omarmustafa130/robo-tech-boat/Boat/Additional symbols, footprints, & 3D parts/CAN/LIB_MS-22D28-G020/MS-22D28-G020/3D/MS-22D28-G020.stp

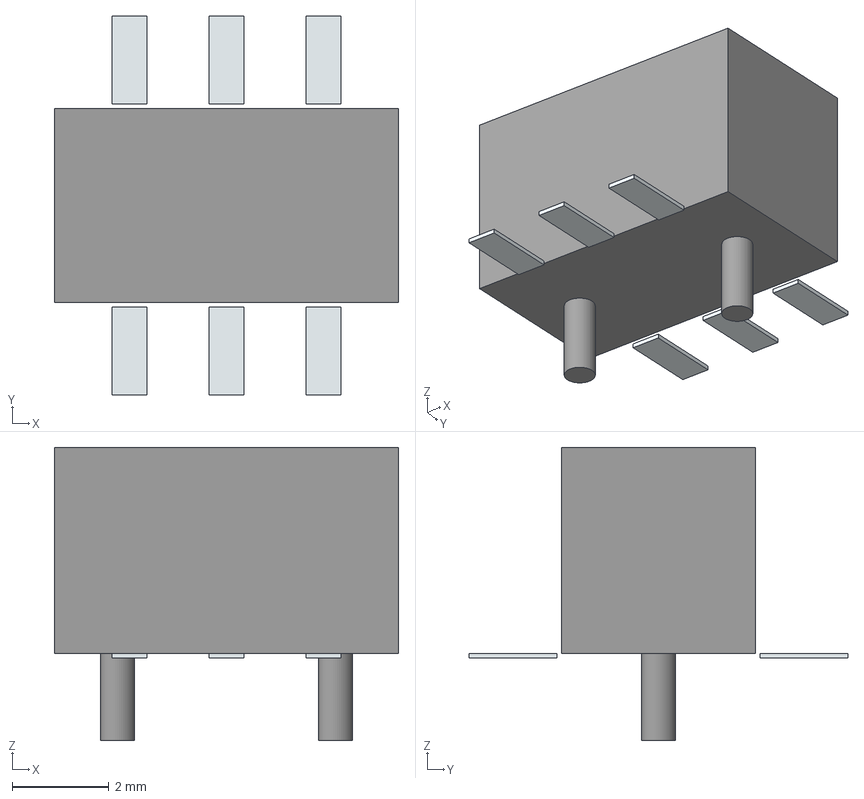
[picture p1: CAD file, 2025-05-22]
Boat/Additional symbols, footprints, & 3D parts/CAN/LIB_MS-22D28-G020/MS-22D28-G020/3D/MS-22D28-G020.stp
7.10 x 7.82 x 6.05 mm
Pins
Lugs
