omarmustafa130/robo-tech-boat/Boat/Additional symbols, footprints, & 3D parts/ENC28J60-I_SO/ENC28J60-I_SO.step

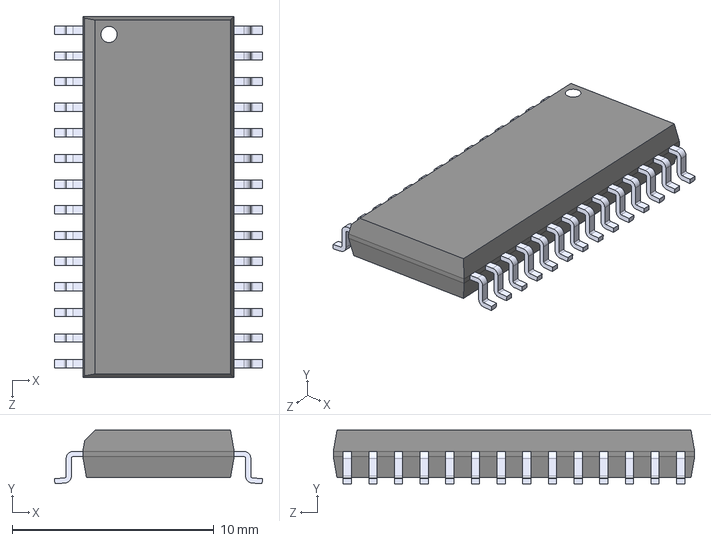
[picture p2: CAD file, 2025-05-22]
Boat/Additional symbols, footprints, & 3D parts/ENC28J60-I_SO/ENC28J60-I_SO.step
10.3 x 2.65 x 17.9 mm
