omarmustafa130/robo-tech-boat/Boat/Additional symbols, footprints, & 3D parts/ETHERNET/LIB_HSO321S/HSO321S/3D/HSO321S.stp

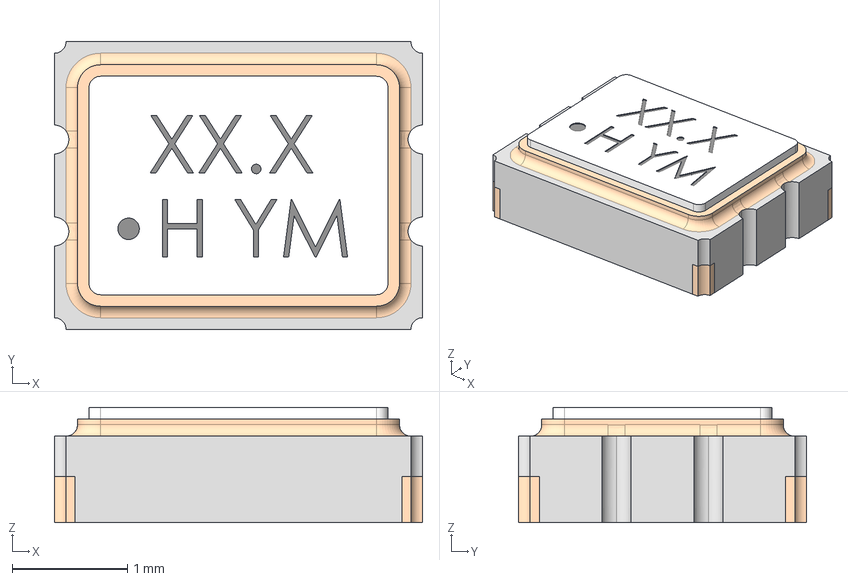
[picture p3: CAD file, 2025-05-22]
Boat/Additional symbols, footprints, & 3D parts/ETHERNET/LIB_HSO321S/HSO321S/3D/HSO321S.stp
3.20 x 2.50 x 1.00 mm
SSW024576F3CHC-T
SSW024576F3CHC-T003
SSW024576F3CHC-T004
SSW024576F3CHC-T002
SSW024576F3CHC-T001
