omarmustafa130/robo-tech-boat/Boat/Additional symbols, footprints, & 3D parts/ETHERNET/LIB_W5500/W5500/3D/W5500.stp

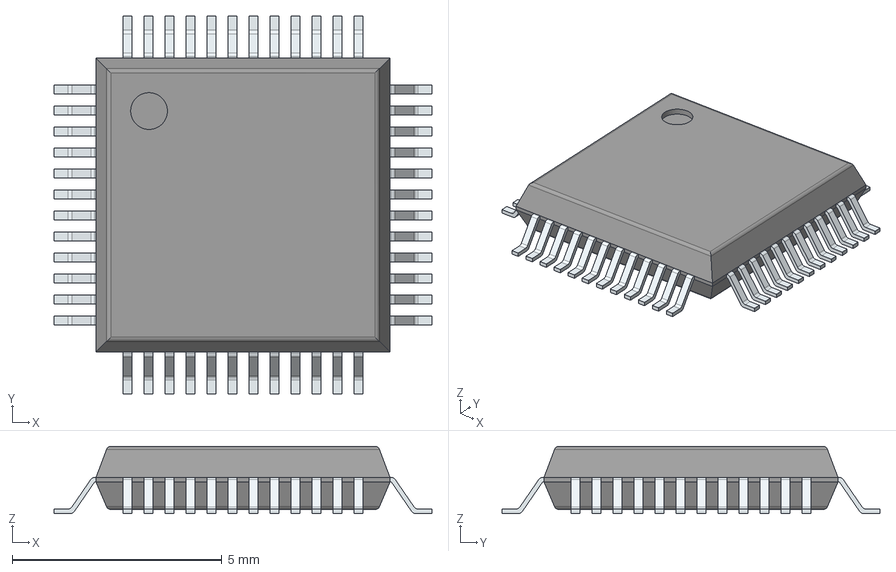
[picture p4: CAD file, 2025-05-22]
Boat/Additional symbols, footprints, & 3D parts/ETHERNET/LIB_W5500/W5500/3D/W5500.stp
9.00 x 9.00 x 1.60 mm
PinsArrayLR
PinsArrayTB
