omarmustafa130/robo-tech-boat/Boat/Additional symbols, footprints, & 3D parts/ETHERNET/RJ45_163141781-659-5-2301994-9/5-2301994-9.stp

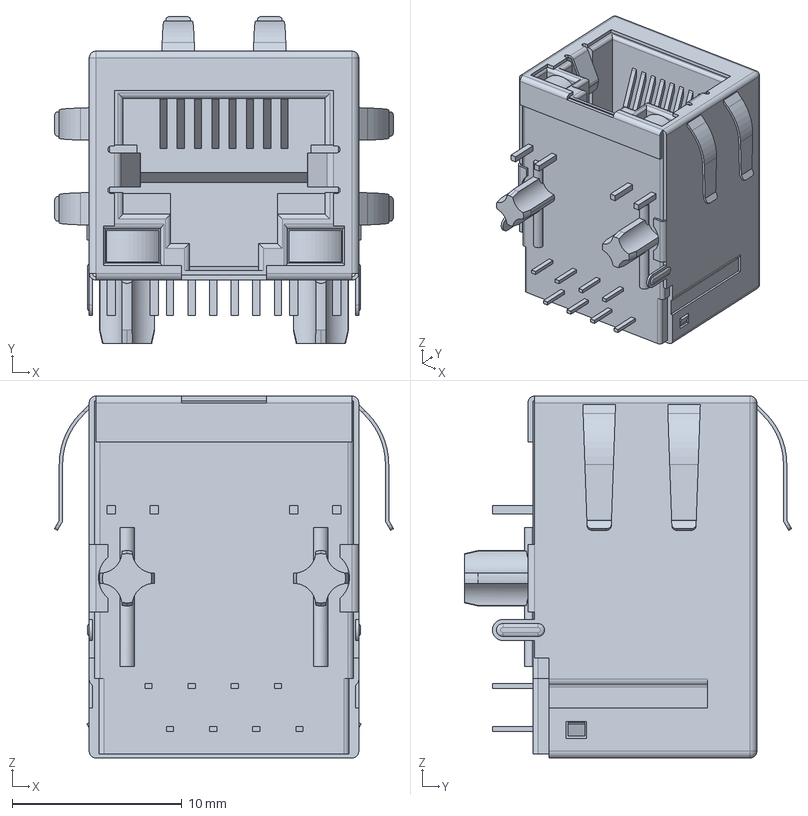
[picture p5: CAD file, 2025-05-22]
Boat/Additional symbols, footprints, & 3D parts/ETHERNET/RJ45_163141781-659-5-2301994-9/5-2301994-9.stp
20.0 x 19.3 x 21.4 mm
