omarmustafa130/robo-tech-boat/Boat/Additional symbols, footprints, & 3D parts/Power Circuit/LIB_1N5822/1N5822/3D/1N5822.stp

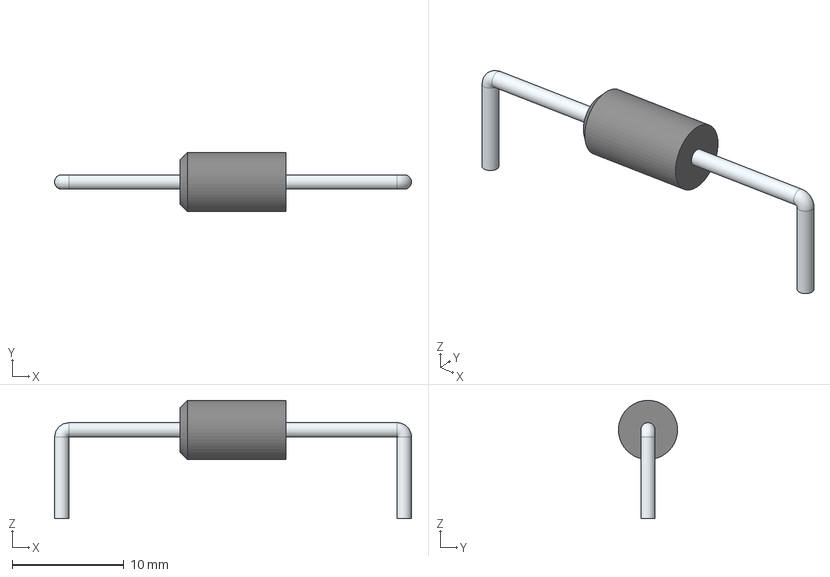
[picture p6: CAD file, 2025-05-22]
Boat/Additional symbols, footprints, & 3D parts/Power Circuit/LIB_1N5822/1N5822/3D/1N5822.stp
32.0 x 5.30 x 10.6 mm
