omarmustafa130/robo-tech-boat/Boat/Additional symbols, footprints, & 3D parts/Power Circuit/LIB_SMAJ58A/SMAJ58A/3D/SMAJ58A.stp

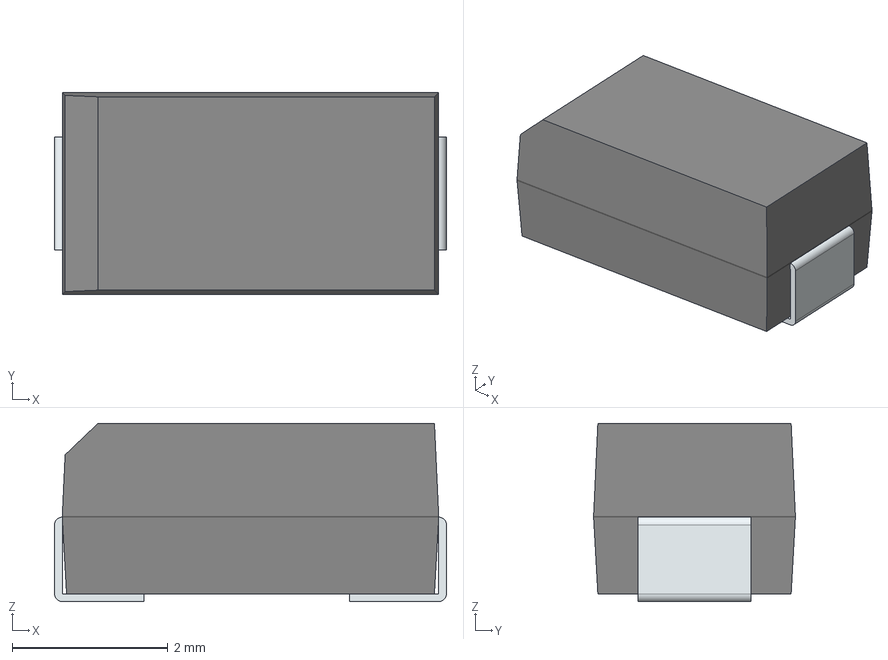
[picture p7: CAD file, 2025-05-22]
Boat/Additional symbols, footprints, & 3D parts/Power Circuit/LIB_SMAJ58A/SMAJ58A/3D/SMAJ58A.stp
5.04 x 2.60 x 2.29 mm
FilletPin1
FilletPin2
