omarmustafa130/robo-tech-boat/Boat/Additional symbols, footprints, & 3D parts/Power Circuit/LIB_TX4138/TX4138/3D/TX4138.stp

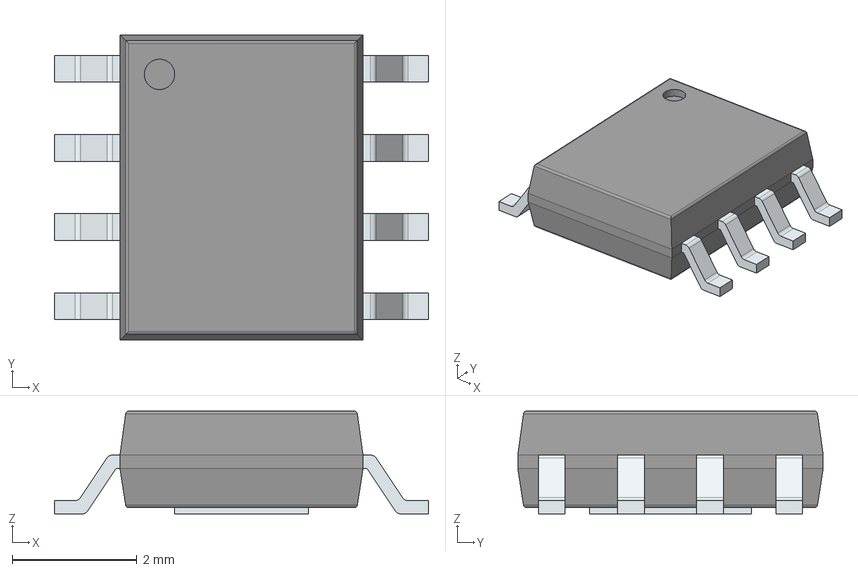
[picture p9: CAD file, 2025-05-22]
Boat/Additional symbols, footprints, & 3D parts/Power Circuit/LIB_TX4138/TX4138/3D/TX4138.stp
6.00 x 4.90 x 1.65 mm
PinsArrayLR
ThermalPad
