omarmustafa130/robo-tech-boat/Boat/Additional symbols, footprints, & 3D parts/Power Circuit/NR3015T2R2M/NR3015T2R2M.step

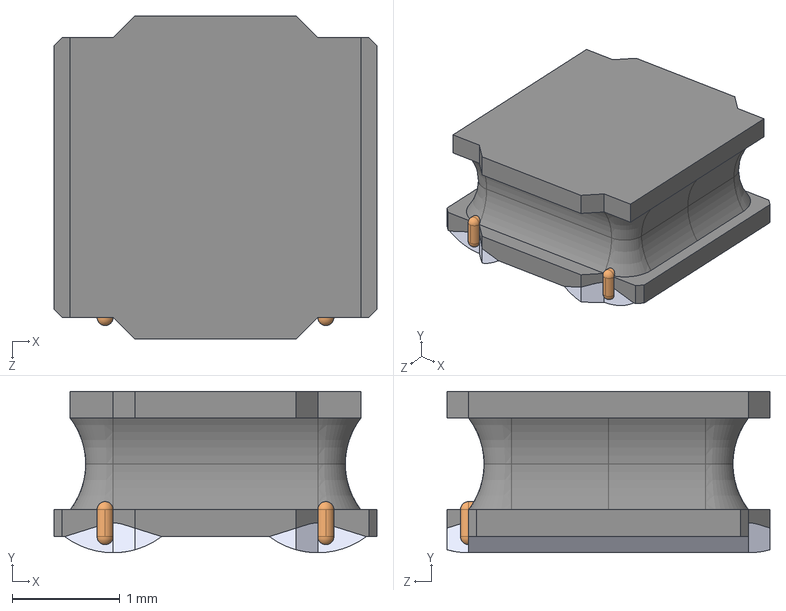
[picture p10: CAD file, 2025-05-22]
Boat/Additional symbols, footprints, & 3D parts/Power Circuit/NR3015T2R2M/NR3015T2R2M.step
3.00 x 1.50 x 3.00 mm
