omarmustafa130/robo-tech-boat/Boat/Additional symbols, footprints, & 3D parts/Power Circuit/SS310/SS310.step

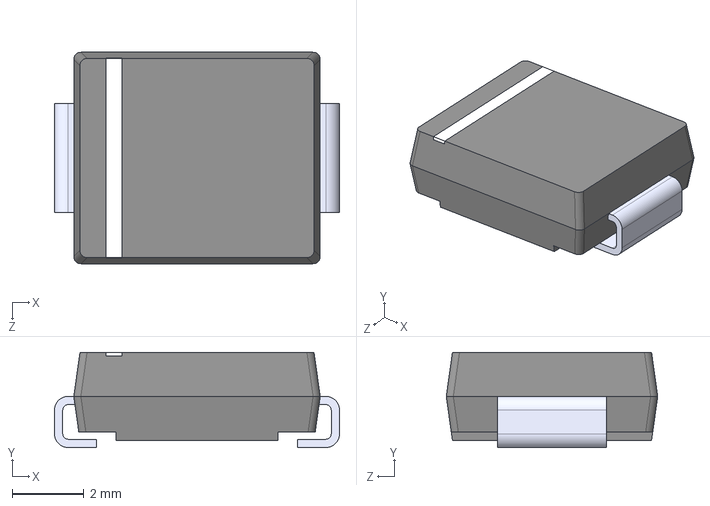
[picture p11: CAD file, 2025-05-22]
Boat/Additional symbols, footprints, & 3D parts/Power Circuit/SS310/SS310.step
7.95 x 2.65 x 5.90 mm
