omarmustafa130/robo-tech-boat/Boat/Additional symbols, footprints, & 3D parts/RELAYS/LIB_1N4148W/1N4148W/3D/1N4148W.stp

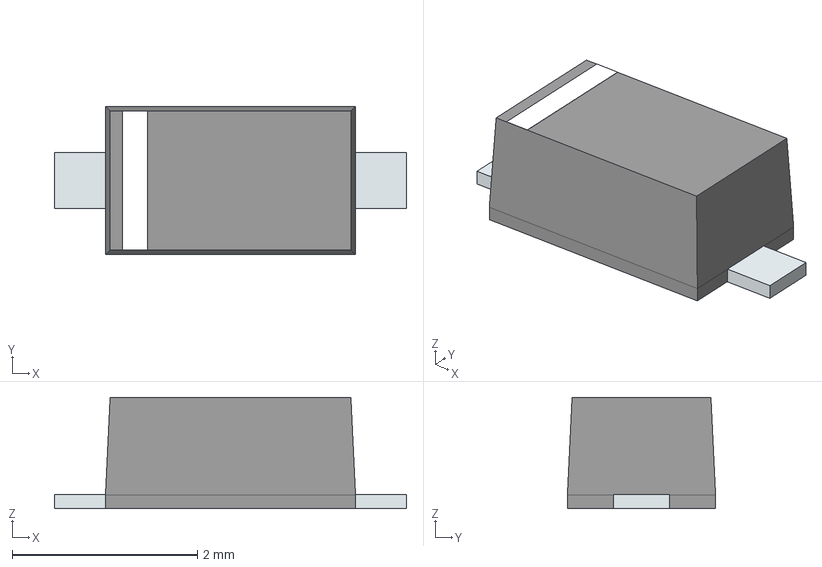
[picture p12: CAD file, 2025-05-22]
Boat/Additional symbols, footprints, & 3D parts/RELAYS/LIB_1N4148W/1N4148W/3D/1N4148W.stp
3.80 x 1.60 x 1.20 mm
PinKIdent
PinK
PinA
