omarmustafa130/robo-tech-boat/Boat/Additional symbols, footprints, & 3D parts/RELAYS/LIB_LMUN2235LT1G/LMUN2235LT1G/3D/LMUN2235LT1G.stp

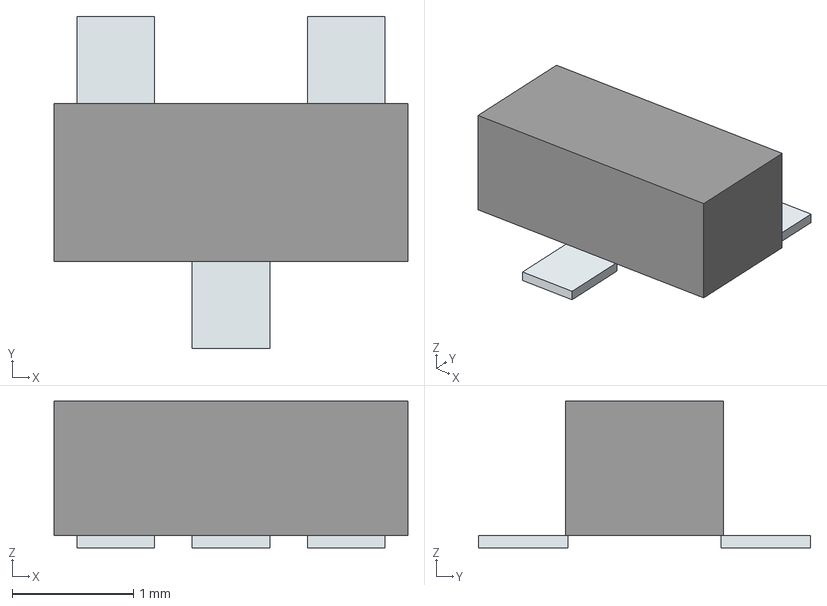
[picture p13: CAD file, 2025-05-22]
Boat/Additional symbols, footprints, & 3D parts/RELAYS/LIB_LMUN2235LT1G/LMUN2235LT1G/3D/LMUN2235LT1G.stp
2.92 x 2.74 x 1.21 mm
Pins
