omarmustafa130/robo-tech-boat/Boat/Additional symbols, footprints, & 3D parts/RELAYS/SRD-05VDC-SL-C/SRD-05VDC-SL-C.step

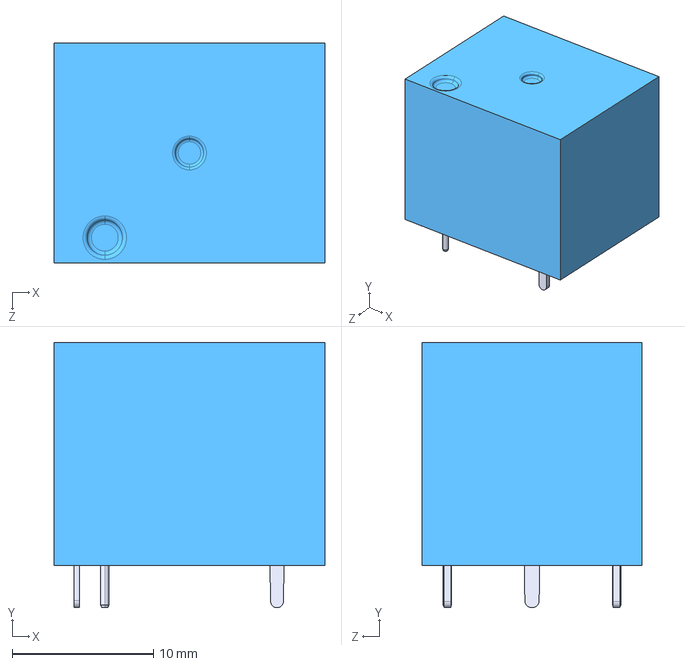
[picture p14: CAD file, 2025-05-22]
Boat/Additional symbols, footprints, & 3D parts/RELAYS/SRD-05VDC-SL-C/SRD-05VDC-SL-C.step
19.2 x 18.8 x 15.6 mm
