omarmustafa130/robo-tech-boat/Boat/Additional symbols, footprints, & 3D parts/SN65HVD233DRG4/SN65HVD233DRG4.step

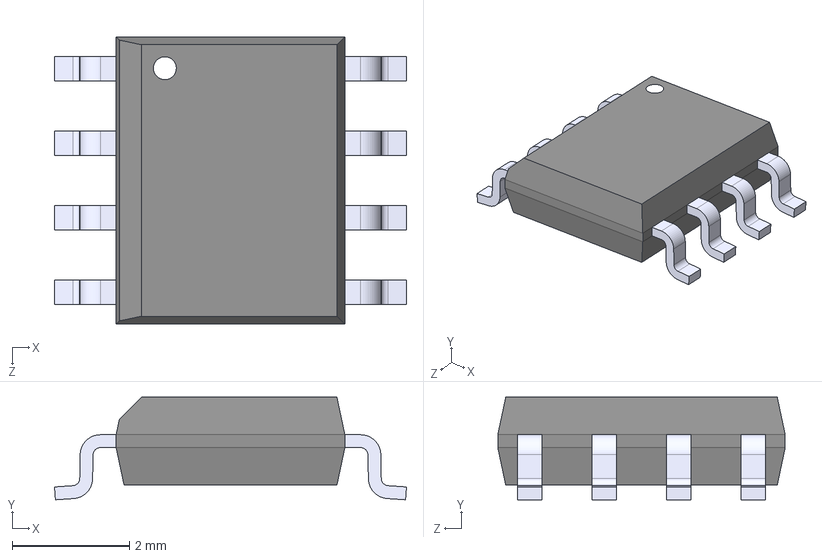
[picture p15: CAD file, 2025-05-22]
Boat/Additional symbols, footprints, & 3D parts/SN65HVD233DRG4/SN65HVD233DRG4.step
6.00 x 1.75 x 4.90 mm
