omarmustafa130/robo-tech-boat/Boat/Additional symbols, footprints, & 3D parts/USB_TTL/LIB_CP2102N-A01-GQFN28/CP2102N-A01-GQFN28/3D/CP2102N-A01-GQFN28.stp

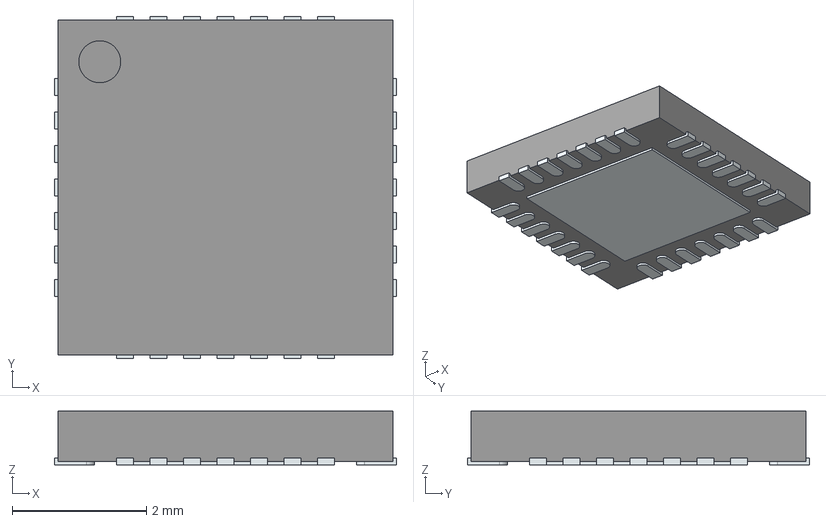
[picture p16: CAD file, 2025-05-22]
Boat/Additional symbols, footprints, & 3D parts/USB_TTL/LIB_CP2102N-A01-GQFN28/CP2102N-A01-GQFN28/3D/CP2102N-A01-GQFN28.stp
5.10 x 5.10 x 0.8 mm
ThermalPin
PinsArrayLR
PinsArrayTB
