omarmustafa130/robo-tech-boat/Boat/Additional symbols, footprints, & 3D parts/USB_TTL/LIB_SS8050-G/SS8050-G/3D/SS8050-G.stp

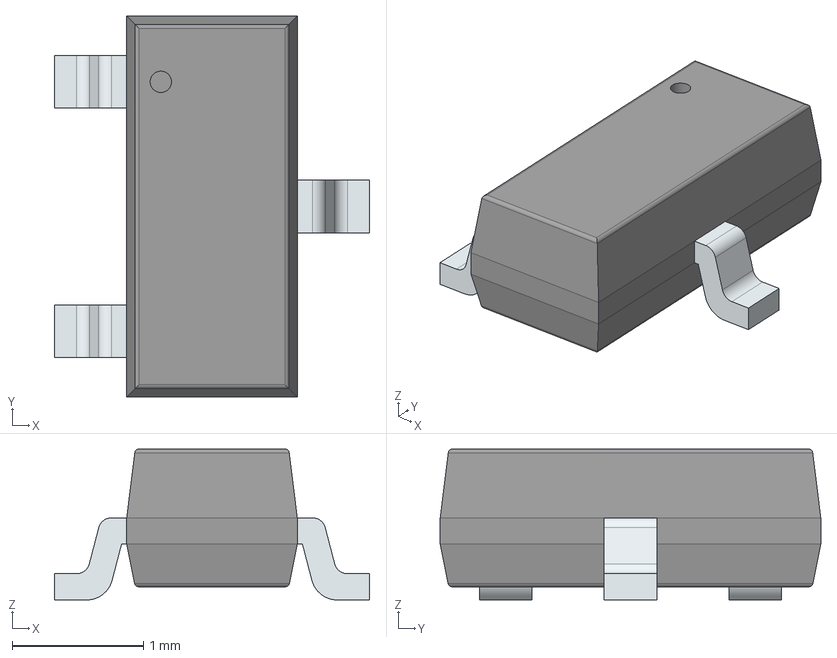
[picture p17: CAD file, 2025-05-22]
Boat/Additional symbols, footprints, & 3D parts/USB_TTL/LIB_SS8050-G/SS8050-G/3D/SS8050-G.stp
2.40 x 2.90 x 1.15 mm
PinsArrayL
FilletPinR
