omarmustafa130/robo-tech-boat/Boat/Additional symbols, footprints, & 3D parts/XRCGB24M000F2P00R0/XRCGB24M000F2P00R0.step

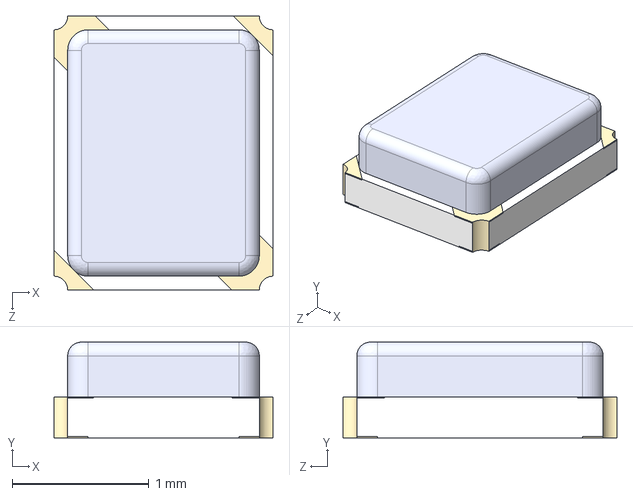
[picture p18: CAD file, 2025-05-22]
Boat/Additional symbols, footprints, & 3D parts/XRCGB24M000F2P00R0/XRCGB24M000F2P00R0.step
1.60 x 0.7 x 2.00 mm
