omarmustafa130/robo-tech-boat/(list of files, cad)

Other CAD files:
Boat/Additional symbols, footprints, & 3D parts/CAN/LIB_MS-22D28-G020/MS-22D28-G020/Allegro/ms22d28g020.psm
Boat/Additional symbols, footprints, & 3D parts/CAN/LIB_MS-22D28-G020/MS-22D28-G020/DEHDL/ms_22d28_g020/chips/chips.prt
Boat/Additional symbols, footprints, & 3D parts/ETHERNET/LIB_HSO321S/HSO321S/Allegro/hso321s.psm
Boat/Additional symbols, footprints, & 3D parts/ETHERNET/LIB_HSO321S/HSO321S/DEHDL/hso321s/chips/chips.prt
Boat/Additional symbols, footprints, & 3D parts/ETHERNET/LIB_W5500/W5500/Allegro/qfp50p900x900x160-48n.psm
Boat/Additional symbols, footprints, & 3D parts/ETHERNET/LIB_W5500/W5500/DEHDL/w5500/chips/chips.prt
Boat/Additional symbols, footprints, & 3D parts/LIB_MCP23017T-E_ML/MCP23017T-E_ML/3D/MCP23017T-E_ML.stp
Boat/Additional symbols, footprints, & 3D parts/LIB_MCP23017T-E_ML/MCP23017T-E_ML/Allegro/qfn65p600x600x100-29n-d.psm
Boat/Additional symbols, footprints, & 3D parts/LIB_MCP23017T-E_ML/MCP23017T-E_ML/DEHDL/mcp23017t_e_ml/chips/chips.prt
Boat/Additional symbols, footprints, & 3D parts/LIB_MS-22D28-G020/MS-22D28-G020/Allegro/ms22d28g020.psm
Boat/Additional symbols, footprints, & 3D parts/LIB_MS-22D28-G020/MS-22D28-G020/DEHDL/ms_22d28_g020/chips/chips.prt
Boat/Additional symbols, footprints, & 3D parts/Power Circuit/LIB_1N5822/1N5822/Allegro/dioad3070w130l950d530.psm
Boat/Additional symbols, footprints, & 3D parts/Power Circuit/LIB_1N5822/1N5822/DEHDL/1n5822/chips/chips.prt
Boat/Additional symbols, footprints, & 3D parts/Power Circuit/LIB_694106301002/694106301002/3D/694106301002.stp
Boat/Additional symbols, footprints, & 3D parts/Power Circuit/LIB_694106301002/694106301002/Allegro/694106301002_1.psm
Boat/Additional symbols, footprints, & 3D parts/Power Circuit/LIB_694106301002/694106301002/DEHDL/694106301002/chips/chips.prt
Boat/Additional symbols, footprints, & 3D parts/Power Circuit/LIB_SMAJ58A/SMAJ58A/Allegro/diom5026x229n.psm
Boat/Additional symbols, footprints, & 3D parts/Power Circuit/LIB_SMAJ58A/SMAJ58A/DEHDL/smaj58a/chips/chips.prt
Boat/Additional symbols, footprints, & 3D parts/Power Circuit/LIB_SMD_IC_SY8089AAAC/SMD_IC_SY8089AAAC/Allegro/sot95p285x140-5n.psm
Boat/Additional symbols, footprints, & 3D parts/Power Circuit/LIB_SMD_IC_SY8089AAAC/SMD_IC_SY8089AAAC/DEHDL/smd_ic_sy8089aaac/chips/chips.prt
Boat/Additional symbols, footprints, & 3D parts/Power Circuit/LIB_TX4138/TX4138/Allegro/soic127p600x165-9n.psm
Boat/Additional symbols, footprints, & 3D parts/Power Circuit/LIB_TX4138/TX4138/DEHDL/tx4138/chips/chips.prt
Boat/Additional symbols, footprints, & 3D parts/Power Circuit/LIB_WPM2015-3_TR/WPM2015-3_TR/Allegro/sot95p240x130-3n.psm
Boat/Additional symbols, footprints, & 3D parts/Power Circuit/LIB_WPM2015-3_TR/WPM2015-3_TR/DEHDL/wpm2015_3_tr/chips/chips.prt
Boat/Additional symbols, footprints, & 3D parts/Power Circuit/ScrewTerminal_691213510002+(rev1)/Download_STP_691213510002+%28rev1%29.stp
Boat/Additional symbols, footprints, & 3D parts/RELAYS/LIB_1N4148W/1N4148W/Allegro/sodfl3816x120n.psm
Boat/Additional symbols, footprints, & 3D parts/RELAYS/LIB_1N4148W/1N4148W/DEHDL/1n4148w/chips/chips.prt
Boat/Additional symbols, footprints, & 3D parts/RELAYS/LIB_LMUN2235LT1G/LMUN2235LT1G/Allegro/lmun2235lt1g.psm
Boat/Additional symbols, footprints, & 3D parts/RELAYS/LIB_LMUN2235LT1G/LMUN2235LT1G/DEHDL/lmun2235lt1g/chips/chips.prt
Boat/Additional symbols, footprints, & 3D parts/USB_TTL/LIB_CP2102N-A01-GQFN28/CP2102N-A01-GQFN28/Allegro/qfn50p500x500x80-29n-d.psm
Boat/Additional symbols, footprints, & 3D parts/USB_TTL/LIB_CP2102N-A01-GQFN28/CP2102N-A01-GQFN28/DEHDL/cp2102n_a01_gqfn28/chips/chips.prt
Boat/Additional symbols, footprints, & 3D parts/USB_TTL/LIB_SS8050-G/SS8050-G/Allegro/sot95p240x115-3n.psm
Boat/Additional symbols, footprints, & 3D parts/USB_TTL/LIB_SS8050-G/SS8050-G/DEHDL/ss8050_g/chips/chips.prt
