omarmustafa130/robo-tech-boat/Boat/Boat/Boat.kicad_pcb

## KiCad design Boat/Boat/Boat.kicad_pcb (2025-05-22)

Schematic: Boat.kicad_sch, Boat Hardware System

Parts:
C1: 4.7nF; C_0603_1608Metric
C2, C20: 10uF/16V; C_0603_1608Metric
C3, C4, C14, C15, C16, C19, C21: 0.1uF; C_0603_1608Metric
C5: 100uF/63V/20%/10x13MM/Low_ESR/RM5; C_0603_1608Metric
C6: 100uF/100V/10%/X7R/C0603; C_0603_1608Metric
C7: 100nf/100V/10%/X7R/C0603; C_0603_1608Metric
C8, C11, C12, C32, C33, C34: 22uF/6.3V/20%/X5R/C0603; C_0603_1608Metric
C9: 12pF/50V/5%/COG/C0402; C_0402_1005Metric
C10: 470uF/10V/RVT1A471M0607; CP_Elec_6.3x7.7
C13, C41, C49, C50, C52, C53, C56, C58, C59, C60: 100nF; C_0603_1608Metric
C17, C18: 18pF; C_0402_1005Metric
C22, C24, C51, C57: 10nF; C_0603_1608Metric
C23: 4.7uF; C_0603_1608Metric
C25: 22nF; C_0603_1608Metric
C26, C27: 6.8nF; C_0603_1608Metric
C28: 1nF/2kV; C_0603_1608Metric
C29, C31: 4.7uF/6.3V (10%); C_0603_1608Metric
C30, C35: 0.1uF/50V (10%); C_0603_1608Metric
C36, C37, C38, C39, C42, C43, C46, C47, C48: 2.2uF; C_0603_1608Metric
C40: 1uF/10V/10%/X5R/C0603; C_0603_1608Metric
C44, C45: 10pF; C_0603_1608Metric
D1: SMAJ58A; D_SMA
D2: LED/RED/0603; LED_0603_1608Metric
D3: SS310; D_SMA
D4, D5, D6, D7, D8, D10, D11, D20: 1N4148W(SOD-123); 1N4148W_SODFL3816X120N
D9: 1N5822; D_DO-201AD_P15.24mm_Horizontal
D15, D17, D18: LED; LED_0603_1608Metric
D16: NUP2105L; SOT-23
IC1, IC2: SMD_IC_SY8089AAAC; SY80B9AAAC_SOT95P285X140-5N; Mouser Part Number 909-SMDICSY8089AAAC
IC3, IC4: MIC2099-1YMTTR; MIC2099_SON50P160X160X60-7N-D; Manufacturer_Part_Number MIC2099-1YMTTR
J1: J1B1211CCD; Mouser Part Number 950-J1B1211CCD
J2, J3, J6, J13, J14, J17, J18, J19: Screw_Terminal_01x02; Altech_AK100_1x02_P5.00mm
J4, J16: Screw_Terminal_01x03; Altech_AK100_1x03_P5.00mm
J7, J8, J9, J10, J15: Screw_Terminal_01x06; Altech_AK100_1x06_P5.00mm
J11, J12: Conn_01x03_Pin; JST_EH_B3B-EH-A_1x03_P2.50mm_Vertical
J22: USB_C_Receptacle_USB2.0_16P; USB_C_Receptacle_HRO_TYPE-C-31-M-12
K1, K2, K3, K4, K5, K6, K7, K8: SRD-05VDC-SL-C; RELAY_SRD-05VDC-SL-C
L1: 600R; R_0402_1005Metric
L2: 33uH/SL0630-330M; SL0630-330M
L3, L4: 2.2uH/1.5A/DCR=72mR/20%/3.00x3.00x1.50mm/CD32(NR3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; IND_NR3015T2R2M
L6: 120R 3A; L_0603_1608Metric
Q1: WPM2015-3/TR; WPM2015-3TR_SOT95P240X130-3N
Q2, Q3, Q4, Q5: SS8050-G(RANGE:120-200); SS8050_SOT95P240X115-3N
Q6: BC817; SOT-23
R1, R2, R10, R11, R12: 330R; R_0603_1608Metric
R3: 2.2k/R0402; R_0402_1005Metric
R4: 0.03R/1%/R1206; R_1206_3216Metric
R5: 4.7R/R0402; R_0402_1005Metric
R6: 5.23k/1%/R0402; R_0402_1005Metric
R7: 30.1k/1%/R0402; R_0402_1005Metric
R8, R56: 220k/R0402; R_0402_1005Metric
R9, R57: 49.9k/1%/R0402; R_0402_1005Metric
R13, R41: 22.1k (5%); R_0603_1608Metric
R14, R42: 47.5k (5%); R_0603_1608Metric
R15, R17, R48, R53, R54, R55: 100k; R_0603_1608Metric
R16: 1M; R_0402_1005Metric
R18, R43: 2k (5%); R_0603_1608Metric
R19, R27, R28, R29, R30: 0R; R_0402_1005Metric
R20, R21, R22, R23, R24, R25: 20R; R_0402_1005Metric
R26: 12.4k/1%; R_0402_1005Metric
R31, R32, R33, R34: 49R9/1%; R_0402_1005Metric
R35: 10R/1%; R_0402_1005Metric
R36, R37: 330R; R_0402_1005Metric
R38, R58: 100R/R0402; R_0402_1005Metric
R39, R40: 10k; R_0603_1608Metric
R44, R45, R49, R59: 10k (5%); R_0603_1608Metric
R46, R47, R60, R61: 0R (5%); R_0603_1608Metric
R50: 12k; R_0603_1608Metric
R51: 120R; R_0402_1005Metric
R52, R68: 10k; R_0402_1005Metric
R67: 1k; R_0402_1005Metric
R86: 10k/R0402; R_0402_1005Metric
S1: MS-22D28-G020; MS22D28G020; Manufacturer_Part_Number MS-22D28-G020
SW1, SW3, SW4: TS665CJ; SW_PUSH_6mm
SW2, SW5: SW_DPST_x2; Power Switch - RS601HL-1010011BB
T1, T2, T3, T4, T5, T6, T7, T9: LMUN2235LT1G(SOT-23); LMUN2235LT1G
TX4138(ESOIC-8)1: TX4138_SOIC127P600X165-9N
U1, U13: CP2102N-Axx-xQFN28; QFN-28-1EP_5x5mm_P0.5mm_EP3.35x3.35mm
U2, U3: ESP32-WROOM-32
U4: W5500; LQFP-48_7x7mm_P0.5mm
U5, U7: MCP23017T-E/ML; MCP23017T-E_ML_QFN65P600X600X100-29N-D
U6: SN65HVD233; SOIC-8_3.9x4.9mm_P1.27mm
U8: USBLC6-2SC6; SOT-23-6
U9: SPX3819M5-L-3-3; SOT-23-5
U10: USB2514B_Bi; QFN-36-1EP_6x6mm_P0.5mm_EP3.7x3.7mm
Y1: HSO321S 24MHZ 3.3V -40~+85℃; HSO321S
Y2: XRCGB24M000F2P00R0; OSC_XRCGB24M000F2P00R0; PARTREV N/A

Connections:
3.3V_2: S1.3 (NC_1)
+3.3V: J1.10, J1.12
+3.3VA: C2.1, C3.1, C4.1, C14.1, C15.1, C16.1, C19.1, L1.1, R31.1, R33.1, R35.1, U4.4 (AVDD), U4.8 (AVDD), U4.11 (AVDD), U4.15 (AVDD), U4.17 (AVDD), U4.21 (AVDD)
+3.3V_1: C11.1, C12.1, C29.2, C30.2, L3.2, R8.2, R43.2, R68.1, R86.1, U1.6 (VDD), U1.7 (VREGIN), U3.2 (VDD), U7.9 (VDD)
+3.3V_2: C13.1, C20.1, C21.1, C31.2, C33.1, C34.1, C35.2, C43.1, C48.1, C49.1, C52.1, C56.1, C58.1, C59.1, C60.1, D18.2 (A), J16.1, L1.2, L4.2, R18.2, R56.2, U2.2 (VDD), U4.28 (VDD), U5.9 (VDD), U6.3 (VCC), U9.5 (OUT), U10.5 (VDDA33), U10.10 (VDDA33), U10.15 (VDD33), U10.23 (VDD33), U10.26 (RESET_N), U10.29 (VDDA33), U10.36 (VDDA33), U13.6 (VDD), U13.7 (VREGIN)
+5V: C8.1, C32.1, D4.1 (K), D5.1 (K), D6.1 (K), D7.1 (K), D8.1 (K), D9.1 (K), D10.1 (K), D11.1 (K), D20.1 (K), IC1.1 (EN), IC1.4 (IN), IC2.1 (EN), IC2.4 (IN), K1.A1, K2.A1, K3.A1, K4.A1, K5.A1, K6.A1, K7.A1, K8.A1, Q1.3 (S), R3.1
+5V_EXT: C9.1, C10.1, D9.2 (A), L2.2, Q1.2 (G), R7.1
+5V_HOST_Filtered: C37.1, C38.1, C46.1, C47.1, IC3.6 (VIN), IC4.6 (VIN), L6.2, R15.1, R39.1, R40.1, U9.1 (IN)
+5V_PORT1: C39.1, D15.2 (A), IC3.1 (VOUT)
+5V_PORT2: C42.1, D17.2 (A), IC4.1 (VOUT)
+5V_USB: Q1.1 (D), R13.1, R41.1
+12V: C5.1, C6.1, D1.1 (A1), J2.1, J3.1, R4.2, TX4138(ESOIC-8)1.3 (VIN)
/1V2O: C22.1, U4.22 (1V2O)
/ACTLED: R37.2, U4.27 (ACTLED)
/EXRES1: R26.1, U4.10 (EXRES1)
/ILIM: R4.1, TX4138(ESOIC-8)1.2 (ILIM), TX4138(ESOIC-8)1.9 (ILIM)
/LINKLED: R36.2, U4.25 (LINKLED)
/RXN: R29.1, U4.5 (RXN)
/RXP: R30.1, U4.6 (RXP)
/TOCAP: C23.1, U4.20 (TOCAP)
/TXN: R27.1, U4.1 (TXN)
/TXP: R28.1, U4.2 (TXP)
/VBUS_DET: R15.2, R17.1, U9.3 (EN), U10.27 (VBUS_DET)
/XI: C17.1, R16.1, U4.30 (XI/CLKIN), Y1.1
/XO: R16.2, R19.1, U4.31 (XO)
BOOT1: Q3.1 (C), R38.1, U3.25 (IO0)
BOOT2: Q5.1 (C), R58.1, U2.25 (IO0)
CGND: C28.2, J1.8 (GND), J1.13, J1.14
CS: R20.1, U2.36 (IO22)
D: U2.29 (IO5), U3.29 (IO5), U6.1 (D)
D+: J22.A6 (D+), J22.B6 (D+), U8.6 (I/O1)
D-: J22.A7 (D-), J22.B7 (D-), U8.4 (I/O2)
DTR1: Q3.3 (E), R44.1, U1.28 (~DTR)
DTR2: Q5.3 (E), R49.1, U13.28 (~DTR)
ESP_3V3: U5.15 (A0), U5.16 (A1), U5.17 (A2)
ESP_EN: C40.1, Q2.1 (C), Q4.1 (C), R86.2, SW4.1, U2.3 (EN), U3.3 (EN)
FUAL2PIN: U3.6 (IO34)
FUALPIN: U3.7 (IO35)
GND: C1.2, C2.2, C3.2, C4.2, C5.2, C6.2, C8.2, C10.2, C11.2, C12.2, C13.2, C14.2, C15.2, C16.2, C17.2, C18.2, C19.2, C20.2, C21.2, C22.2, C23.2, C24.1, C25.2, C28.1, C29.1, C30.1, C31.1, C32.2, C33.2, C34.2, C35.1, C36.2, C37.2, C38.2, C39.2, C40.2, C41.2, C42.2, C43.2, C44.2, C45.2, C46.2, C47.2, C48.2, C49.2, C50.2, C51.2, C52.2, C53.2, C56.2, C57.2, C58.2, C59.2, C60.2, D1.2 (A2), D2.1 (K), D3.2 (A), D16.3 (A), IC1.2 (GND), IC2.2 (GND), IC3.5 (GND), IC3.7 (EP), IC4.5 (GND), IC4.7 (EP), J2.2, J3.2, J7.1, J7.3, J7.5, J8.1, J8.3, J8.5, J9.1, J9.3, J9.5, J10.1, J10.3, J10.5, J11.2, J12.3, J15.1, J15.3, J15.5, J16.3, J22.A1 (GND), J22.A12 (GND), J22.B1 (GND), J22.B12 (GND), Q6.3 (E), R1.1, R2.1, R6.2, R9.2, R10.1, R11.1, R12.2, R14.2, R17.2, R26.2, R42.2, R48.2, R50.1, R52.1, R53.2, R54.2, R55.2, R57.2, SW1.2, SW2.2 (B), SW3.2, SW4.2, SW5.2 (B), T1.2 (E), T2.2 (E), T3.2 (E), T4.2 (E), T5.2 (E), T6.2 (E), T7.2 (E), T9.2 (E), TX4138(ESOIC-8)1.4 (GND), U1.3 (GND), U1.29 (GND), U2.1 (GND), U2.15 (GND), U2.38 (GND), U2.39 (GND), U3.1 (GND), U3.15 (GND), U3.38 (GND), U3.39 (GND), U4.3 (AGND), U4.9 (AGND), U4.14 (AGND), U4.16 (AGND), U4.19 (AGND), U4.29 (GND), U4.48 (AGND), U5.10 (VSS), U5.29 (GND), U6.2 (GND), U7.10 (VSS), U7.15 (A0), U7.16 (A1), U7.17 (A2), U7.29 (GND), U8.2 (GND), U9.2 (GND), U10.11 (TEST), U10.37 (VSS), U13.3 (GND), U13.29 (GND), Y1.2, Y1.4, Y2.2, Y2.4
GNDPWR: C1.1, J22.S1 (SHIELD)
H: D16.1 (K), J11.1, R51.1, U6.7 (CANH)
INT: R24.1, U2.16 (IO13)
IO21/WIRE_SDA_1: U3.21 (SDO/SD0), U7.13 (SDA)
IO21/WIRE_SDA_2: U2.21 (SDO/SD0), U5.13 (SDA)
IO22/WIRE_SCL_1: U3.22 (SDI/SD1), U7.12 (SCK)
IO22/WIRE_SCL_2: U2.22 (SDI/SD1), U5.12 (SCK)
L: D16.2 (K), J11.3, R51.2, U6.6 (CANL)
MISO: R22.1, U2.31 (IO19)
MOSI: R23.1, U2.37 (IO23)
unnamed: C7.1, R5.2
unnamed: C18.1, R19.2, Y1.3
unnamed: C24.2, J1.5, R32.2, R34.2
unnamed: C25.1, J1.2, R35.2
unnamed: C26.1, R29.2, R32.1
unnamed: C26.2, J1.6
unnamed: C27.1, R30.2
unnamed: C27.2, J1.4, R34.1
unnamed: D2.2 (A), R3.2
unnamed: C7.2, D3.1 (K), L2.1, TX4138(ESOIC-8)1.1 (SW)
unnamed: D4.2 (A), K2.A2, T1.3 (C)
unnamed: D5.2 (A), K5.A2, T2.3 (C)
unnamed: D6.2 (A), K3.A2, T3.3 (C)
unnamed: D7.2 (A), K6.A2, T4.3 (C)
unnamed: D8.2 (A), K4.A2, T5.3 (C)
unnamed: D10.2 (A), K7.A2, T6.3 (C)
unnamed: D11.2 (A), K8.A2, T7.3 (C)
unnamed: D15.1 (K), R1.2
unnamed: D17.1 (K), R2.2
unnamed: D18.1 (K), R12.1
unnamed: D20.2 (A), K1.A2, T9.3 (C)
unnamed: IC1.5 (FB), R8.1, R9.1
unnamed: IC1.3 (LX), L3.1
unnamed: IC2.5 (FB), R56.1, R57.1
unnamed: IC2.3 (LX), L4.1
unnamed: IC3.2 (ILIMIT), R10.2
unnamed: IC4.2 (ILIMIT), R11.2
unnamed: J1.1, R28.2, R33.2
unnamed: J1.3, R27.2, R31.2
unnamed: J1.9, R37.1
unnamed: J1.11, R36.1
unnamed: J6.1, K1.NO
unnamed: J6.2, K1.COM
unnamed: J13.1, K2.NO
unnamed: J13.2, K2.COM
unnamed: J14.1, K3.NO
unnamed: J14.2, K3.COM
unnamed: J17.1, K4.NO
unnamed: J17.2, K4.COM
unnamed: J18.1, K5.NO
unnamed: J18.2, K5.COM
unnamed: J19.1, K6.NO
unnamed: J19.2, K6.COM
unnamed: Q2.2 (B), R44.2
unnamed: Q3.2 (B), R45.2
unnamed: Q4.2 (B), R49.2
unnamed: Q5.2 (B), R59.2
unnamed: Q6.2 (B), R67.2
unnamed: R38.2, SW1.1
unnamed: R58.2, SW3.1
unnamed: S1.2 (COM_1), U6.8 (Rs)
unnamed: R52.2, S1.1 (NO_1)
unnamed: R5.1, TX4138(ESOIC-8)1.8 (BS)
unnamed: C9.2, R6.1, R7.2, TX4138(ESOIC-8)1.5 (FB)
unnamed: R41.2, R42.1, U1.8 (VBUS)
unnamed: R43.1, U1.9 (~RST)
unnamed: R22.2, U4.34 (MISO)
unnamed: R23.2, U4.35 (MOSI)
unnamed: R21.2, U4.33 (SCLK)
unnamed: R24.2, U4.36 (~INT)
unnamed: R25.2, U4.37 (~RST)
unnamed: R20.2, U4.32 (~SCS)
unnamed: C41.1, U9.4 (BP)
unnamed: C53.1, C57.1, U10.14 (CRFILT)
unnamed: R55.1, U10.25 (HS_IND/CFG_SEL1)
unnamed: C50.1, C51.1, U10.34 (PLLFILT)
unnamed: R50.2, U10.35 (RBIAS)
unnamed: R48.1, U10.24 (SCL/SMBCLK/CFG_SEL0)
unnamed: R53.1, U10.22 (SDA/SMBDATA/NON_REM1)
unnamed: R54.1, U10.28 (SUSP_IND/LOCAL_PWR/NON_REM0)
unnamed: R13.2, R14.1, U13.8 (VBUS)
unnamed: R18.1, U13.9 (~RST)
OCS_N1: IC3.3 (~FAULT), U10.13 (OCS_N1)
OCS_N2: IC4.3 (~FAULT), U10.17 (OCS_N2)
PRTPWR1: IC3.4 (ENABLE), R39.2, SW2.1 (A), U10.12 (PRTPWR1/BC_EN1)
PRTPWR2: IC4.4 (ENABLE), R40.2, SW5.1 (A), U10.16 (PRTPWR2/BC_EN2)
PUDUNE1: J4.1, K7.NO
PUL1: J7.6, U3.14 (IO12)
PUL1_3: J15.6, U2.10 (IO25)
PUL2: J8.6, U3.16 (IO13)
PUL3: J9.6, U3.13 (IO14)
PUL4: J10.6, U3.23 (IO15)
PUT: J16.2, U2.4 (SENSOR_VP)
PUUP: J4.3, K7.COM, K8.COM
PUUP1: J4.2, K8.NO
R: U2.26 (IO4), U3.26 (IO4), U6.4 (R)
R1: T9.1 (B), U5.1 (GPB0)
R2: T1.1 (B), U5.2 (GPB1)
R3: T2.1 (B), U5.3 (GPB2)
R4: T4.1 (B), U5.4 (GPB3)
R5: T3.1 (B), U5.5 (GPB4)
R6: T5.1 (B), U5.6 (GPB5)
R7: T6.1 (B), U5.7 (GPB6)
R8: T7.1 (B), U5.8 (GPB7)
RST: R25.1, U2.14 (IO12)
RTS1: Q2.3 (E), R45.1, U1.24 (~RTS)
RTS2: Q4.3 (E), R59.1, U13.24 (~RTS)
RX0_1: R47.1, U3.34 (RXD0/IO3)
RX0_2: R61.1, U2.34 (RXD0/IO3)
RXD1: R46.2, U1.25 (RXD)
RXD2: R60.2, U13.25 (RXD)
RXDS: Q6.1 (C), R68.2, U2.27 (IO16), U3.27 (IO16)
SBUSIN: J12.1, R67.1
SCLK: R21.1, U2.30 (IO18)
TX0_1: R46.1, U3.35 (TXD0/IO1)
TX0_2: R60.1, U2.35 (TXD0/IO1)
TXD1: R47.2, U1.26 (TXD)
TXD2: R61.2, U13.26 (TXD)
USBDM_UP: U8.3 (I/O2), U10.30 (USBDM_UP)
USBDP_UP: U8.1 (I/O1), U10.31 (USBDP_UP)
USB_PORT1_M: U1.5 (D-), U10.1 (USBDM_DN1/PRT_DIS_M1)
USB_PORT1_P: U1.4 (D+), U10.2 (USBDP_DN1/PRT_DIS_P1)
USB_PORT2_M: U10.3 (USBDM_DN2/PRT_DIS_M2), U13.5 (D-)
USB_PORT2_P: U10.4 (USBDP_DN2/PRT_DIS_P2), U13.4 (D+)
VBUS_DTS: C36.1, J22.A4 (VBUS), J22.A9 (VBUS), J22.B4 (VBUS), J22.B9 (VBUS), L6.1, U8.5 (VBUS)
XTAL_IN: C45.1, U10.33 (XTALIN/CLKIN), Y2.3
XTAL_OUT: C44.1, U10.32 (XTALOUT), Y2.1
dir1: J7.4, U7.1 (GPB0)
dir1_3: J15.4, U2.11 (IO26)
dir2: J8.4, U7.3 (GPB2)
dir3: J9.4, U7.5 (GPB4)
dir4: J10.4, U7.7 (GPB6)
enable_dc: J15.2, U2.12 (IO27)
enable_stp1: J7.2, U7.2 (GPB1)
enable_stp2: J8.2, U7.4 (GPB3)
enable_stp3: J9.2, U7.6 (GPB5)
enable_stp4: J10.2, U7.8 (GPB7)

Notes on the sheet:
RELAYS
SBUS - NEMA - Relays - Ethernet - DC - Potentiometer
+3.3V
DC Motor + Pot
12Vin
ETHERNET
GPIO EXPANDER
DC-DC Converter 3.3V
SBUS
Power Supply
BOOT 2
USB-TTL 2
ESP32-WROOM32
STEPPER MOTORS
BOOT
USB-TTL
USB HUB
+12V
RESET
GPIO EXPANDER 2
HOST USB-C
+5V
Steppers + Fuel
CAN

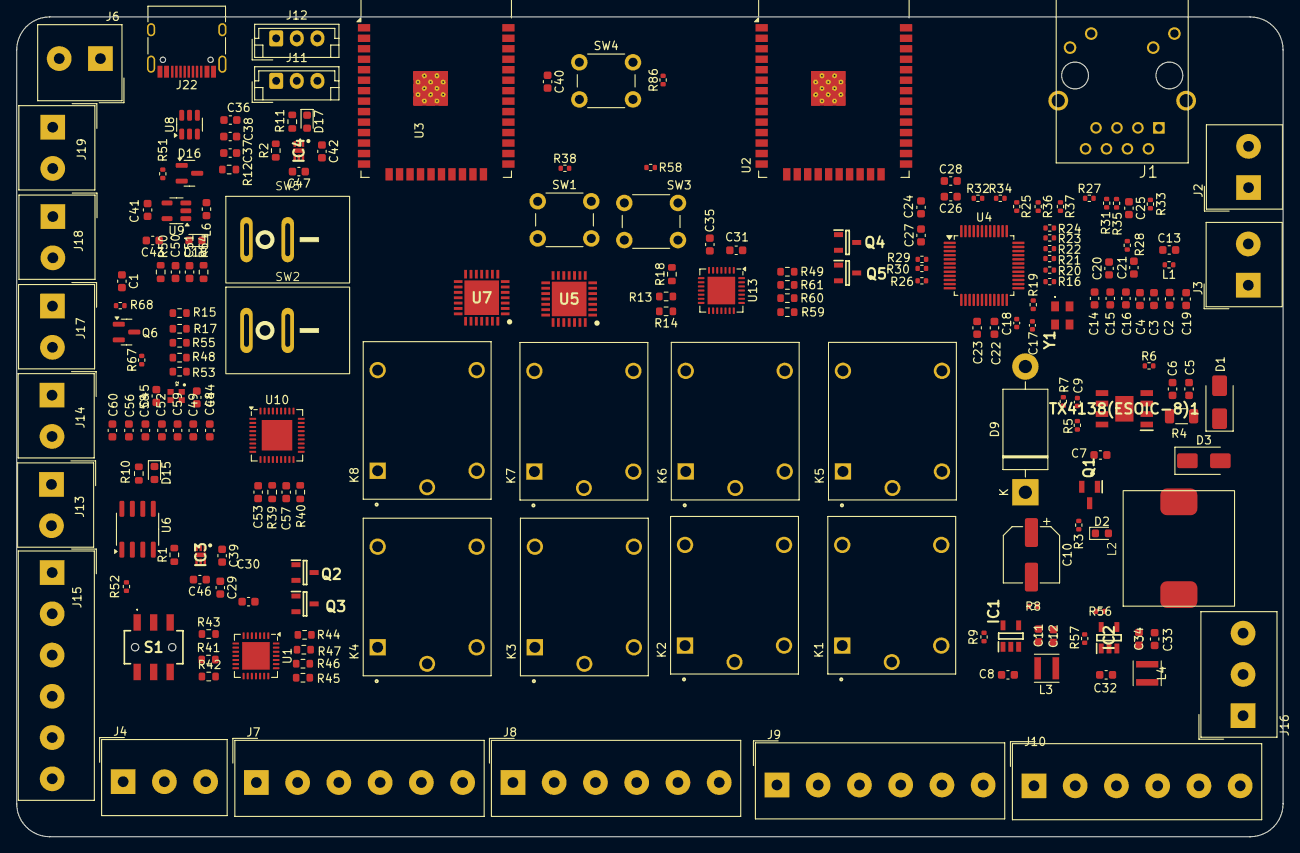
[picture p19: board Boat.kicad_pcb from above]

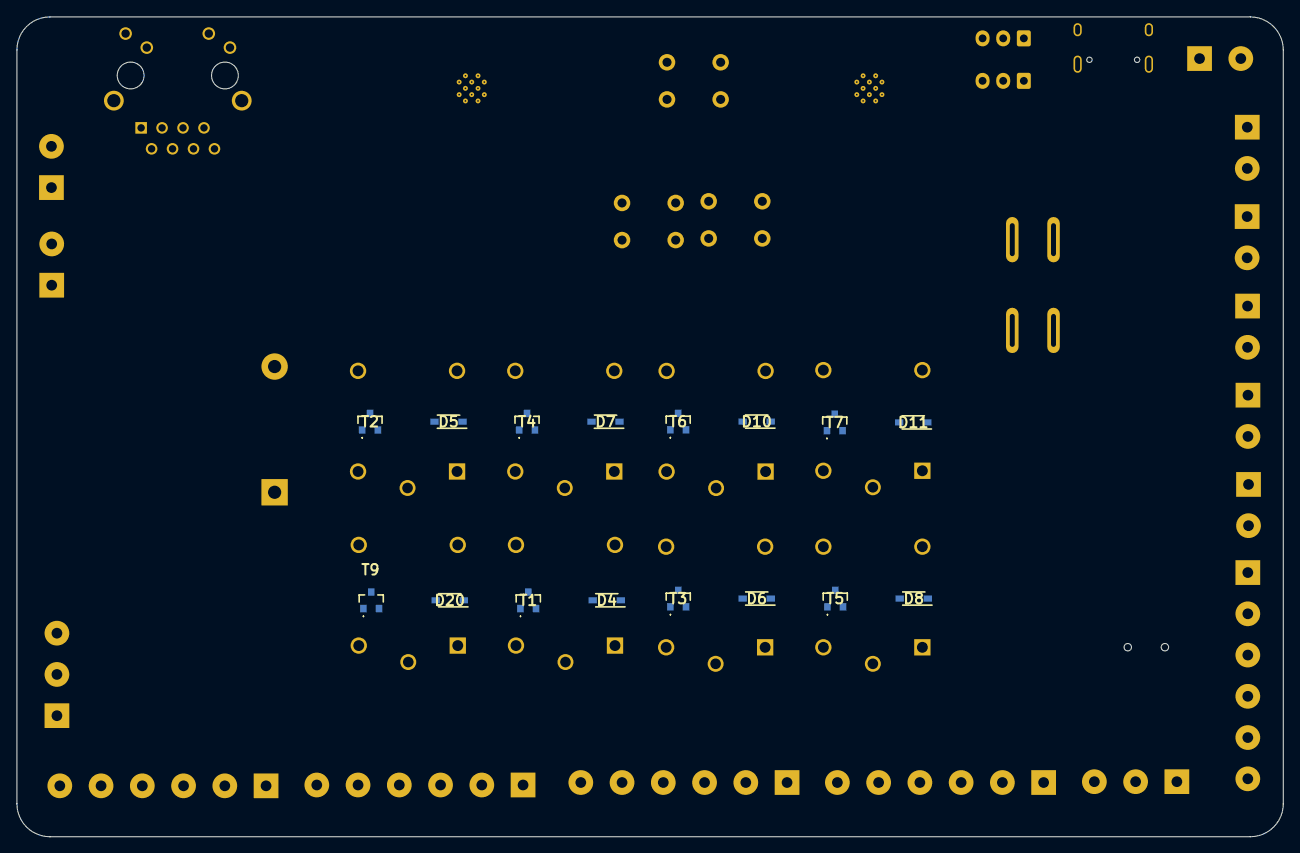
[picture p20: board Boat.kicad_pcb from below]

Board: 2 copper layers, 153.5 x 99.4 mm, 208 parts (16 on the bottom side), 173 nets, no tracks yet.
